kantoniak/intoxicating-innocence-sao/hardware/intoxicating-innocence-sao.kicad_pcb

## KiCad design hardware/intoxicating-innocence-sao.kicad_pcb (2026-10-18)

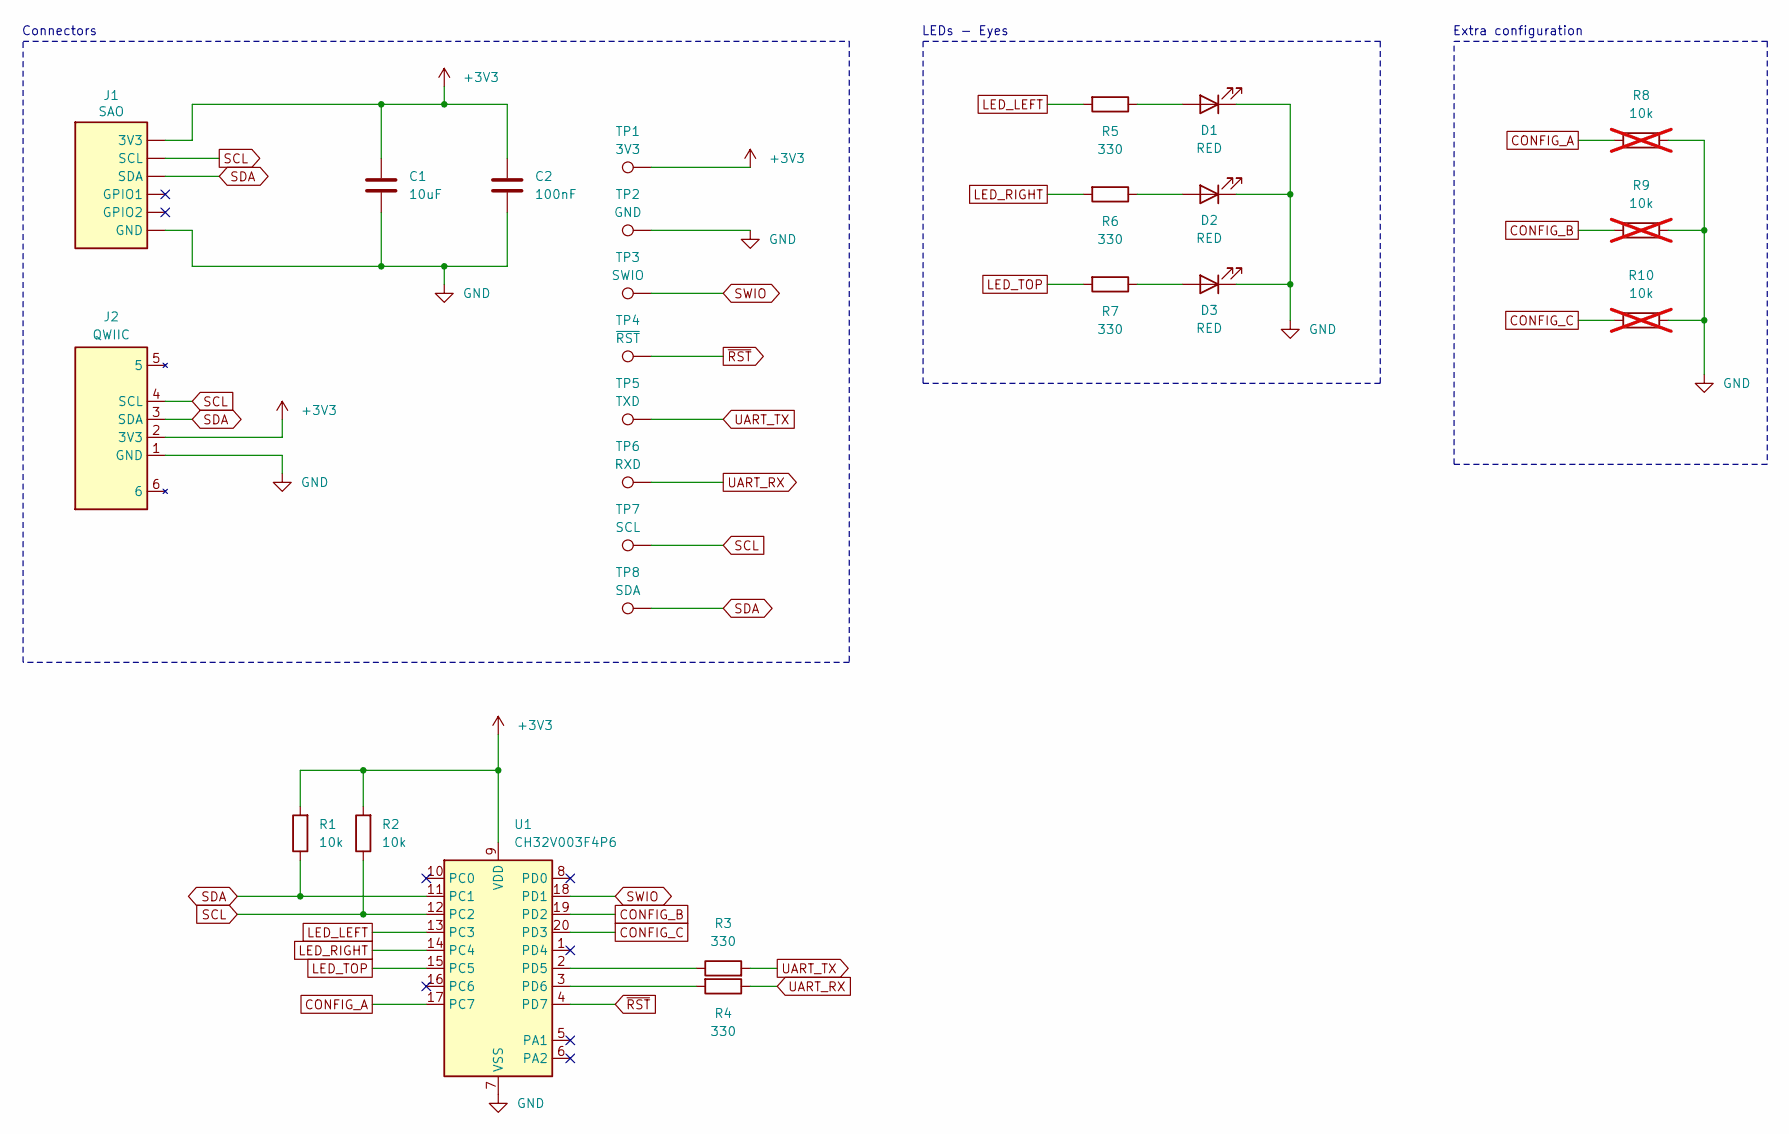
[picture p3: schematic intoxicating-innocence-sao.kicad_sch, Intoxicating Innocence SAO]

Parts:
C1: 10uF; C_0603_1608Metric_Pad1.08x0.95mm_HandSolder; LCSC Part # C109455
C2: 100nF; C_0603_1608Metric_Pad1.08x0.95mm_HandSolder; LCSC Part # C14663
D1, D2, D3: RED; LED_D3.0mm
J1: SAO; SAO_Header_Addon_Side
J2: QWIIC; JST_SH_SM04B-SRSS-TB_1x04-1MP_P1.00mm_Horizontal; Manufacturer Part SM04B-SRSS-TB(LF)(SN); LCSC Part # C160404
R1, R2: 10k; R_0603_1608Metric_Pad0.98x0.95mm_HandSolder; LCSC Part # C25804
R3, R4, R5, R6, R7: 330; R_0603_1608Metric_Pad0.98x0.95mm_HandSolder; LCSC Part # C23345
R8, R9, R10: 10k; R_0603_1608Metric_Pad0.98x0.95mm_HandSolder; not fitted
TP1: 3V3; TestPoint_Pad_D1.5mm
TP2: GND; TestPoint_Pad_D1.5mm
TP3: SWIO; TestPoint_Pad_D1.5mm
TP4: ~{RST}; TestPoint_Pad_D1.5mm
TP5: TXD; TestPoint_Pad_D1.5mm
TP6: RXD; TestPoint_Pad_D1.5mm
TP7: SCL; TestPoint_Pad_D1.5mm
TP8: SDA; TestPoint_Pad_D1.5mm
U1: CH32V003F4P6; TSSOP-20_4.4x6.5mm_P0.65mm; LCSC Part # C5187096

Connections:
+3V3: C1.1, C2.1, J1.6 (3V3), J2.2 (3V3), R1.2, R2.2, TP1.1 (1_1), U1.9 (VDD)
CONFIG_A: R8.1, U1.17 (PC7)
CONFIG_B: R9.2, U1.19 (PD2)
CONFIG_C: R10.2, U1.20 (PD3)
GND: C1.2, C2.2, D1.1 (K), D2.1 (K), D3.1 (K), J1.1 (GND), J2.1 (GND), R8.2, R9.1, R10.1, TP2.1 (1_1), U1.7 (VSS)
LED_LEFT: R5.2, U1.13 (PC3)
LED_RIGHT: R6.2, U1.14 (PC4)
LED_TOP: R7.2, U1.15 (PC5)
unnamed: D1.2 (A), R5.1
unnamed: D2.2 (A), R6.1
unnamed: D3.2 (A), R7.1
unnamed: R3.1, U1.2 (PD5)
unnamed: R4.2, U1.3 (PD6)
SCL: J1.2 (SCL), J2.4 (SCL), R2.1, TP7.1 (1_1), U1.12 (PC2)
SDA: J1.5 (SDA), J2.3 (SDA), R1.1, TP8.1 (1_1), U1.11 (PC1)
SWIO: TP3.1 (1_1), U1.18 (PD1)
UART_RX: R4.1, TP6.1 (1_1)
UART_TX: R3.2, TP5.1 (1_1)
~RST: TP4.1 (1_1), U1.4 (PD7)

Notes on the sheet:
Extra configuration
Connectors
LEDs - Eyes

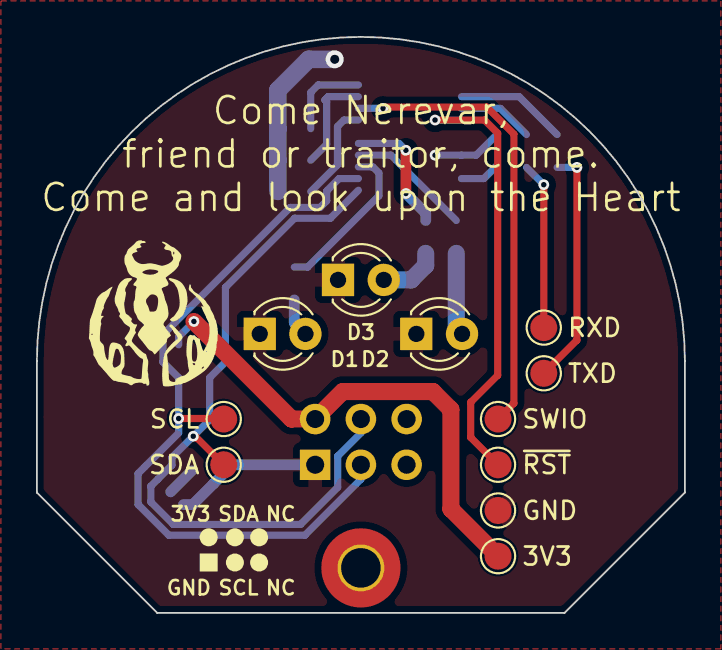
[picture p4: board intoxicating-innocence-sao.kicad_pcb from above]

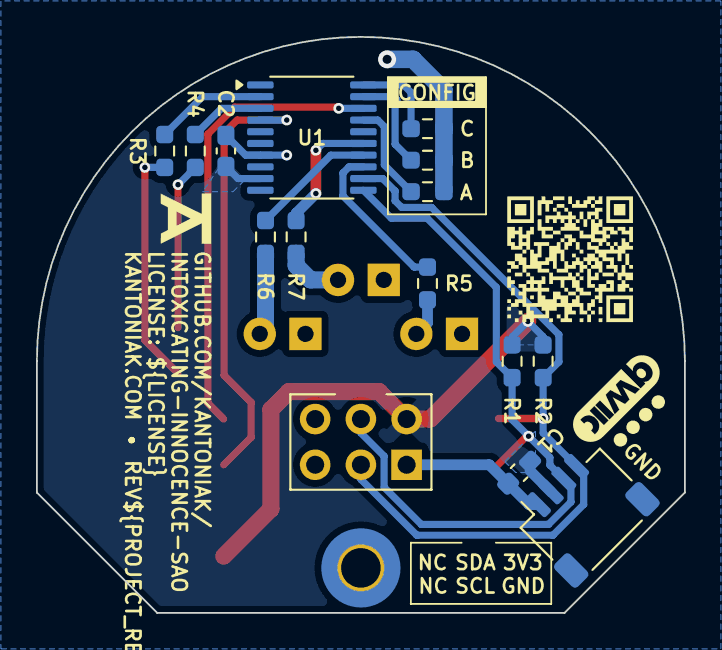
[picture p5: board intoxicating-innocence-sao.kicad_pcb from below]

Board: 2 copper layers, 36.0 x 32.0 mm, 27 parts (16 on the bottom side), 19 nets.

Other parts of the board:
QWIIC_Front: QWIIC_Front; qwiic_logo
