kantoniak/intoxicating-innocence-sao/(commit log)

2026-10-17 Set up Kicad project
2026-10-17 Create board schematic
2026-10-17 Add bulk capacitor
2026-10-17 Add PCB note to README
2026-10-17 Add PCB outline
2026-10-17 Place geometry-informing components on the PCB
2026-10-17 Change stackup to use black soldermask
2026-10-17 Add saved viewports and WIP PCB renders to README
2026-10-18 Route shape-noninforming PCB components
2026-10-18 Fix SCL/SDA routing, add I2C test pads
2026-10-18 Finish silkscreens
2026-10-18 Fix fill zone for PCB
2026-10-18 Fix solder mask to copper clearance value
2026-10-18 Update PCB renders
2026-10-29 Import PCB into enclosure, build PCB envelope volume
2026-10-29 Build compound PCB envelope tester solid
2026-11-07 Separate options for PCB envelope negative volume and envelope tester model
2026-11-07 Update README with intro and assembly instructions
