kantoniak/intoxicating-innocence-sao/(notices)

Notices in the files:
parts and their libraries:
LICENSE: CERN-OHL-S-2.0
